jorenca/battery-capacity-tester/(commit log)

2025-04-07 Initial import of lcd+rotary encoder basic logic
2025-04-14 Add buzzing on rotary encoder input
    [capacity-tester.ino]
2025-04-14 Add debounced start/stop button
2025-04-14 LCD printing via sprintf
2025-04-17 Implement load current and voltage measurement
2025-06-14 Update README and add schematics
